ubruhin/hydro-battery-charger/README.md

# Hydro Battery Charger

## Description

This is a [LibrePCB](https://librepcb.org) project for a hydro power battery
charger PCB, controlled by a STM32L0 microcontroller.

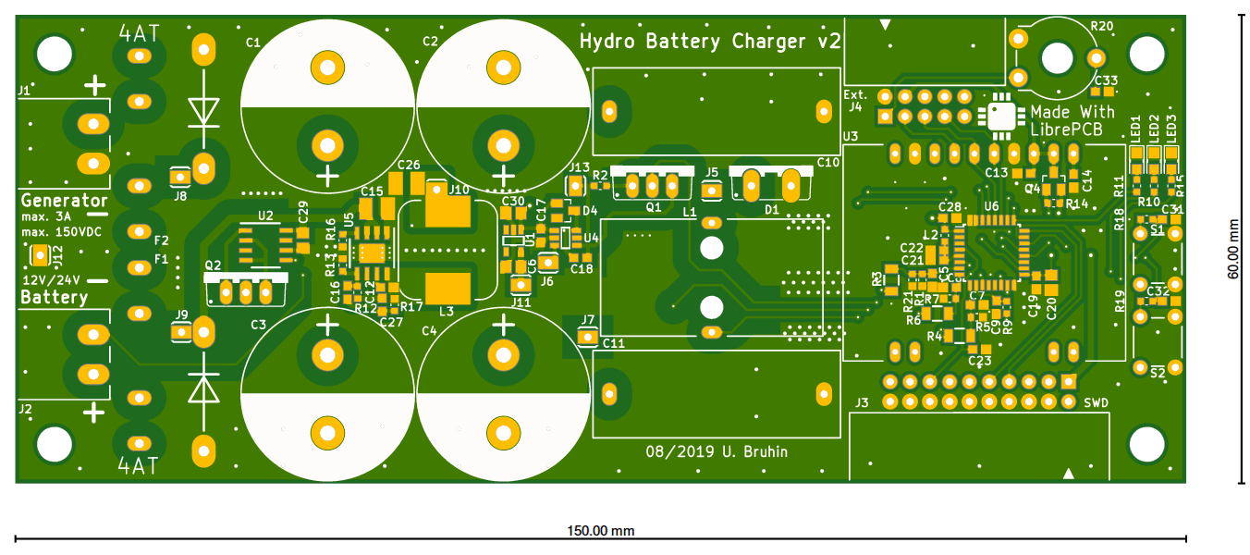
[picture p1: resources/pcb_top.png]
PCB Top


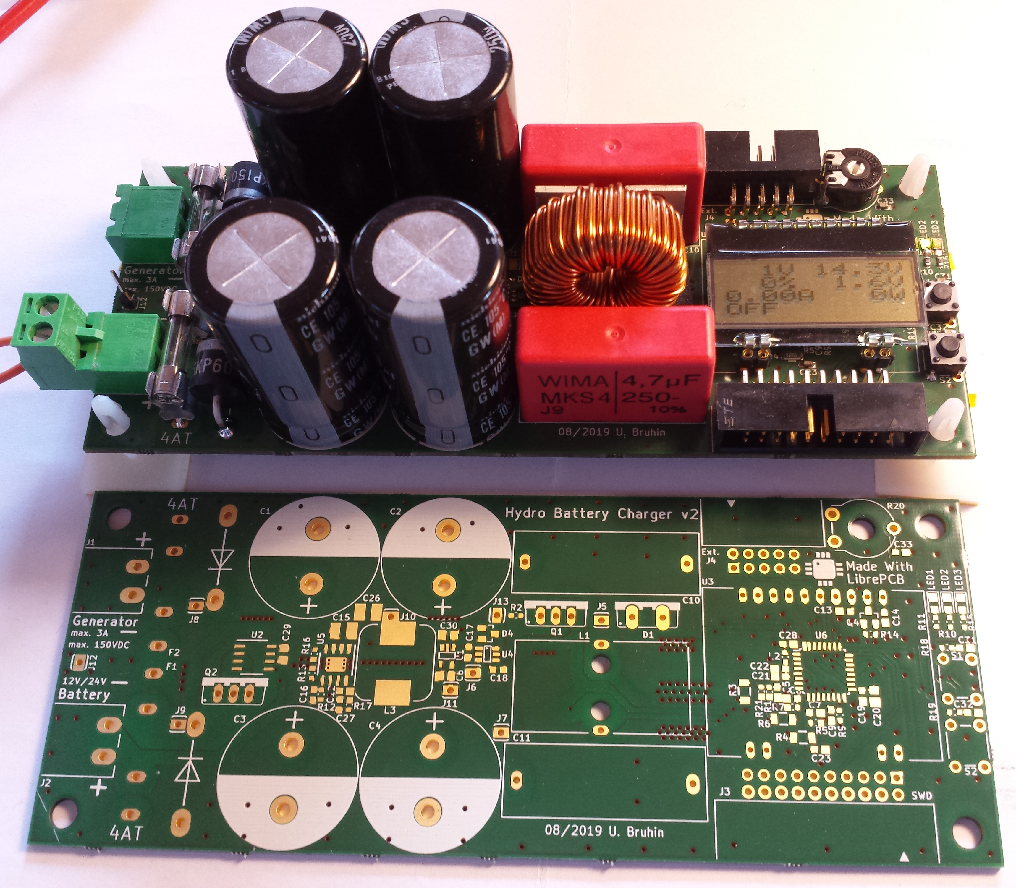
[picture p2: resources/pcb_finished.jpg]
PCB Finished


## License

See [LICENSE.txt](LICENSE.txt).
