ubruhin/hydro-battery-charger/mechanics/button/UM2_button.3mf

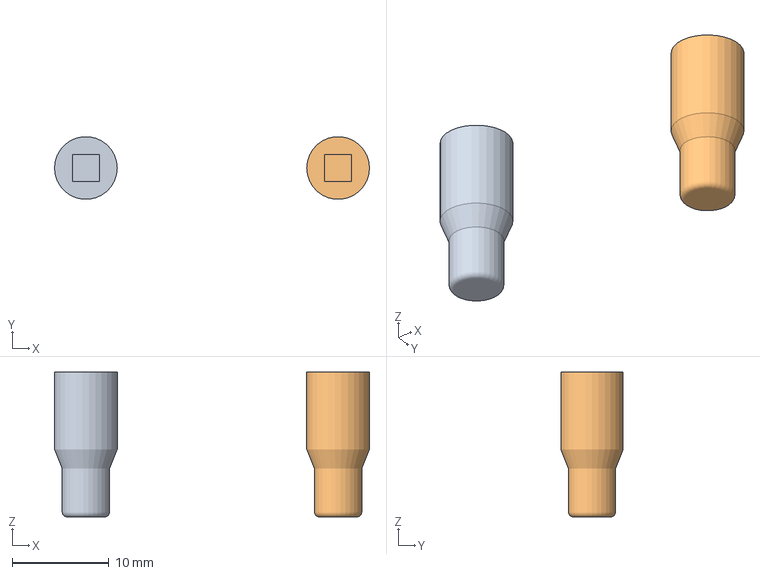
[picture p3: CAD file, 2020-04-19]
mechanics/button/UM2_button.3mf
32.6 x 6.46 x 15.0 mm
