ubruhin/hydro-battery-charger/mechanics/connector_cover/connector_cover.stl

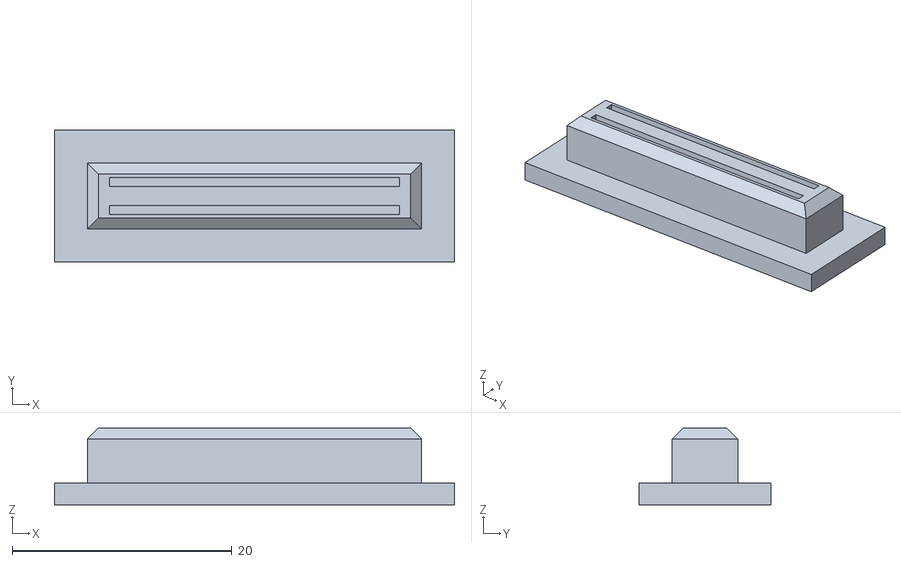
[picture p4: CAD file, 2020-04-19]
mechanics/connector_cover/connector_cover.stl
36.4 x 12.0 x 7.00
