ubruhin/hydro-battery-charger/mechanics/display_holder/display_holder.stl

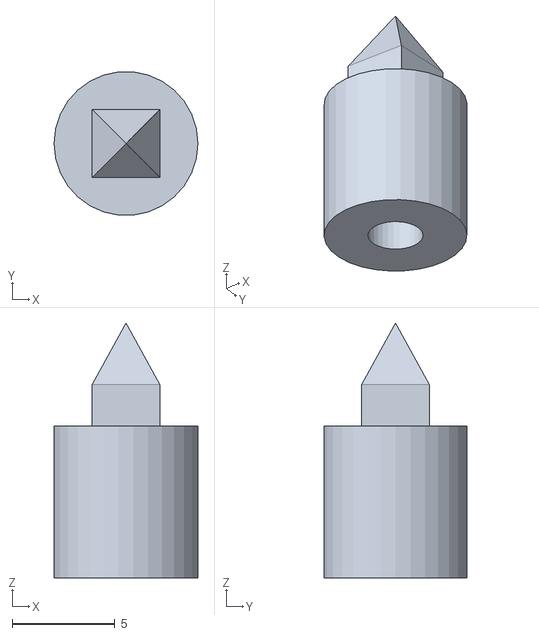
[picture p5: CAD file, 2020-04-19]
mechanics/display_holder/display_holder.stl
7.00 x 6.96 x 12.4
