ubruhin/hydro-battery-charger/mechanics/frontpanel/frontpanel.stl

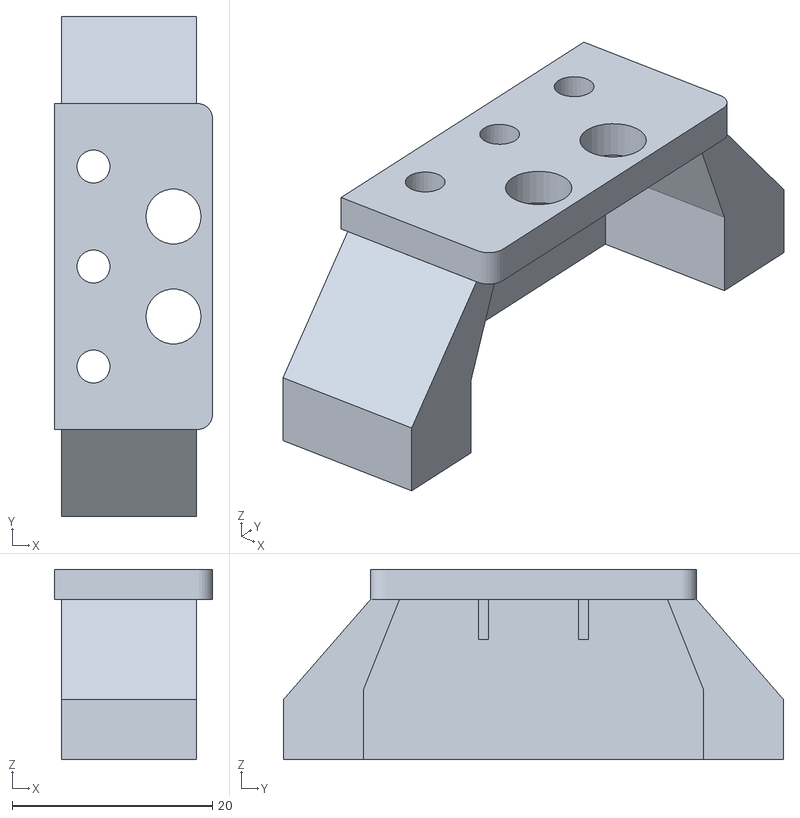
[picture p6: CAD file, 2020-06-29]
mechanics/frontpanel/frontpanel.stl
15.8 x 50.0 x 19.0
