ubruhin/hydro-battery-charger/mechanics/pot_cover/pot_cover.stl

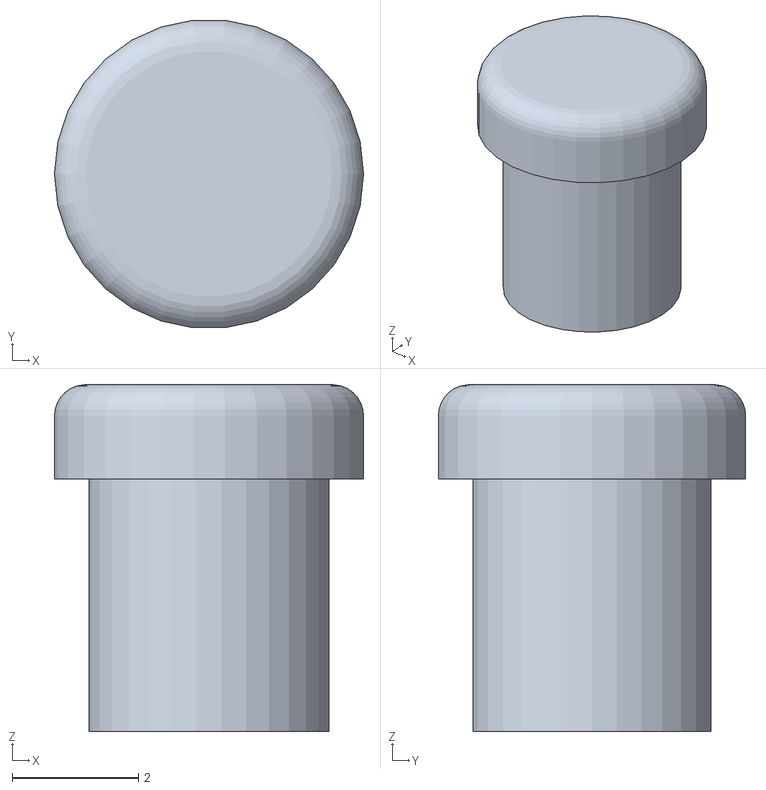
[picture p7: CAD file, 2020-04-19]
mechanics/pot_cover/pot_cover.stl
4.90 x 4.87 x 5.50
