ubruhin/hydro-battery-charger/mechanics/side_cutout/side_cutout_right.dxf

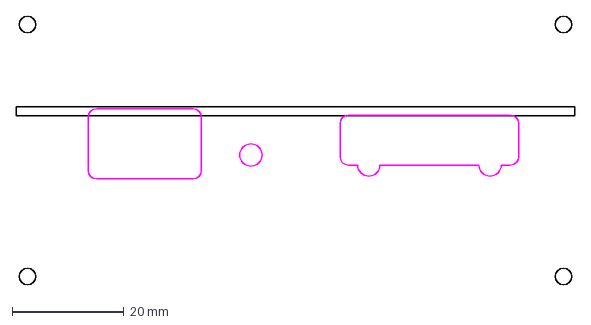
[picture p8: CAD file, 2020-08-07]
mechanics/side_cutout/side_cutout_right.dxf
100.0 x 48.1 mm
