ubruhin/hydro-battery-charger/mechanics/side_label/side_label_right.dxf

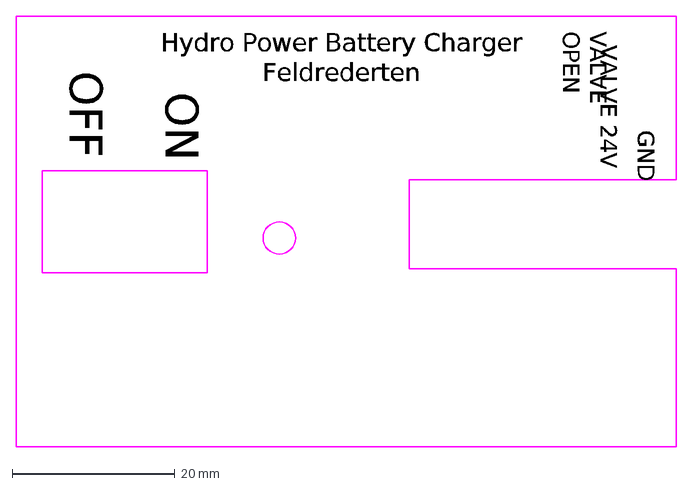
[picture p9: CAD file, 2020-08-07]
mechanics/side_label/side_label_right.dxf
Hydro Power Battery Charger Feldrederten
VALVE 24V
GND
VALVE OPEN
ON
OFF
