ubruhin/hydro-battery-charger/mechanics/button/button.stl

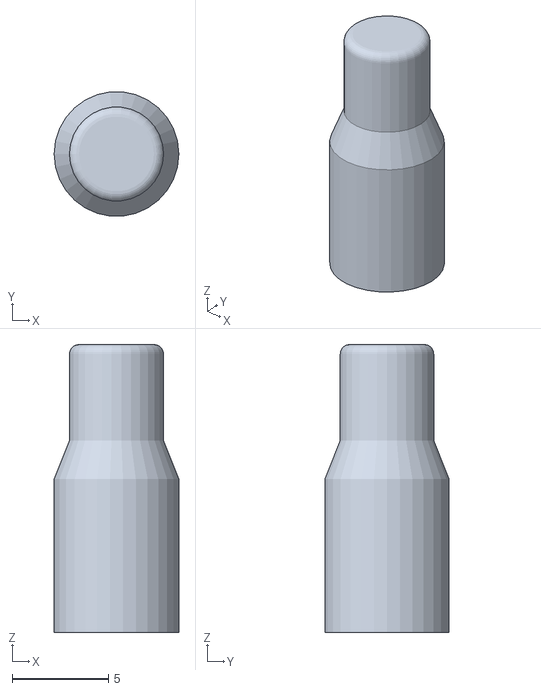
[picture p10: CAD file, 2020-04-19]
mechanics/button/button.stl
6.50 x 6.46 x 15.0
