ubruhin/hydro-battery-charger/mechanics/display_holder/UM2_display_holder.3mf

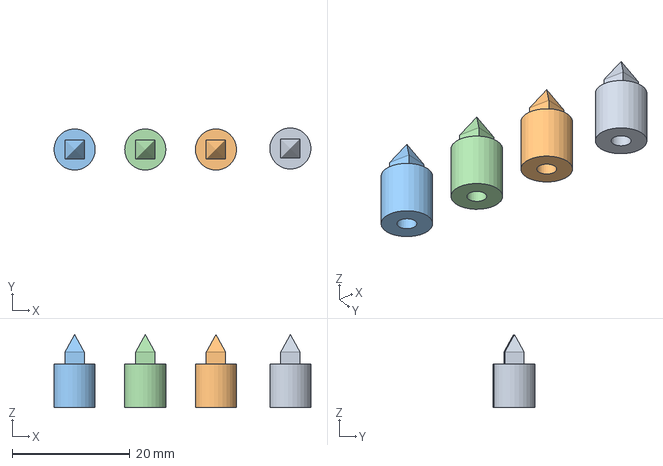
[picture p11: CAD file, 2020-04-19]
mechanics/display_holder/UM2_display_holder.3mf
43.6 x 7.13 x 12.4 mm
