ubruhin/hydro-battery-charger/mechanics/frontpanel/UM2_frontpanel.3mf

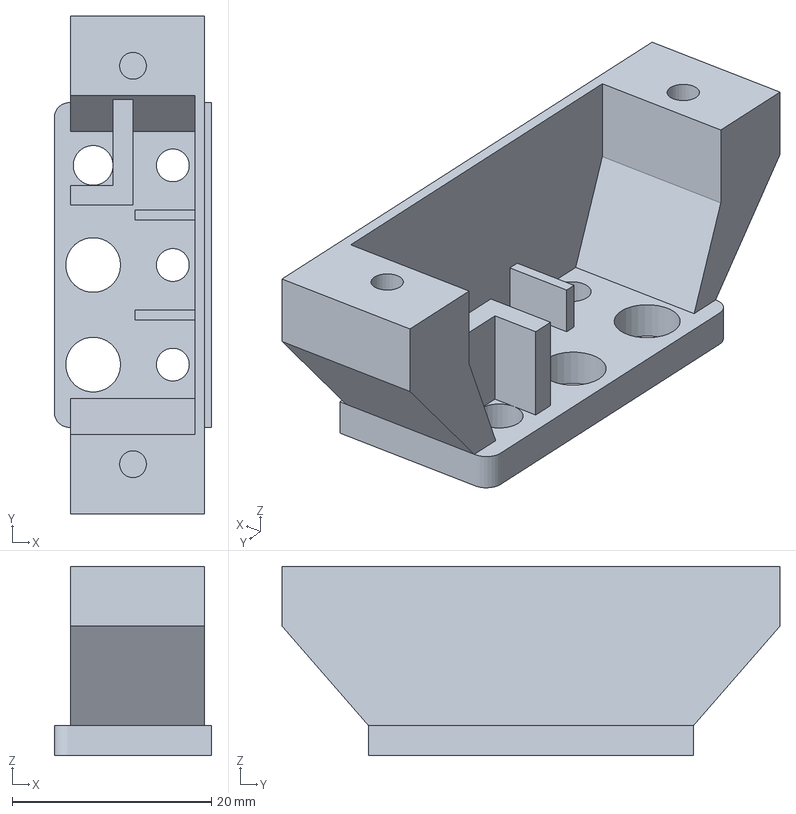
[picture p12: CAD file, 2020-04-19]
mechanics/frontpanel/UM2_frontpanel.3mf
15.8 x 50.0 x 19.0 mm
