ubruhin/hydro-battery-charger/mechanics/side_cutout/side_cutout_left.dxf

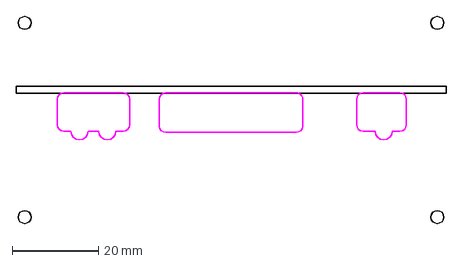
[picture p13: CAD file, 2020-04-19]
mechanics/side_cutout/side_cutout_left.dxf
100.0 x 48.1 mm
