ubruhin/hydro-battery-charger/mechanics/side_label/side_label_left.dxf

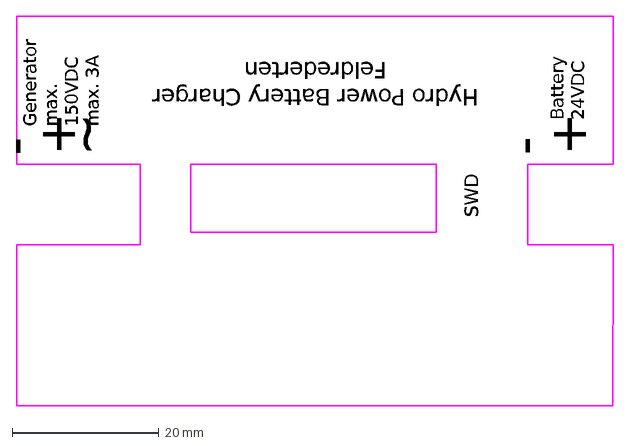
[picture p14: CAD file, 2020-06-07]
mechanics/side_label/side_label_left.dxf
SWD
Hydro Power Battery Charger Feldrederten
+
-
~
Battery 24VDC
Generator max. 150VDC max. 3A
