ubruhin/hydro-battery-charger/(list of files, cad)

Other CAD files:
mechanics/connector_cover/UM2_connector_cover.3mf
mechanics/pot_cover/UM2_pot_cover.3mf
