ubruhin/hydro-battery-charger/pcb/CHANGELOG.md

# Hydro Battery Charger

## Unreleased

- Maybe add motor driver to control a valve?

## v3

- Simplify button circuits to fix WKUP feature
- Replace display by NHD-0420AZ-FSW-GBW-33V3
- Add RPM measure circuit
- Remove ext. connector
- Complete redesign of board to fit in a enclosure

## v2

- Change R3/R4/R6 to 1206 package

## v1

- Initial version
