ubruhin/hydro-battery-charger/pcb/output/v4/Hydro_Battery_Charger_Board_Bottom.pdf

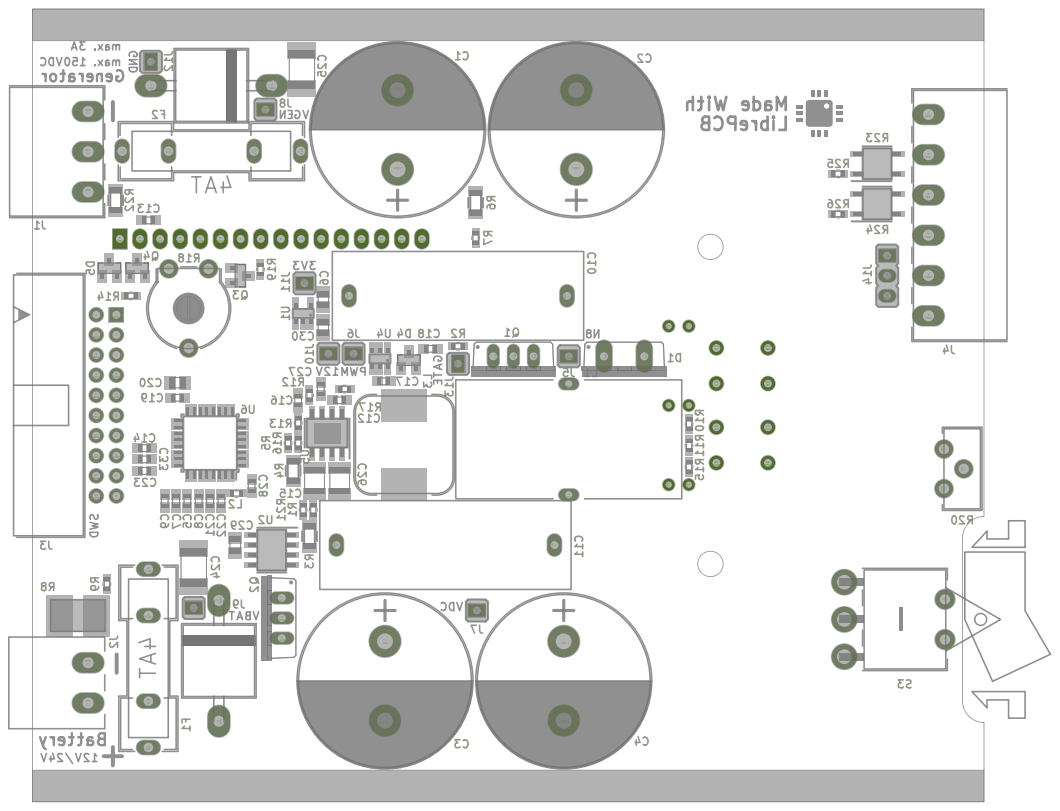
[picture p15: page 1]
S: POT; A: GND; VDC; 2: GND; 1: VGEN; GND C:; 3V3_DISPLAY A:; 1: VDC; C: GND; 2A: BUTTON2; 2B: BUTTON2; 5: GND; 11: DISPLAY_DB4; 14: DISPLAY_DB7; 15: N13 8 4: DISPLAY_RS; 6: DISPLAY_E; 2: 3V3_DISPLAY; 12: DISPLAY_DB5; 16: GND; 13: DISPLAY_DB6; 1: GND
