ubruhin/hydro-battery-charger/mechanics/side_label/side_label_right.pdf

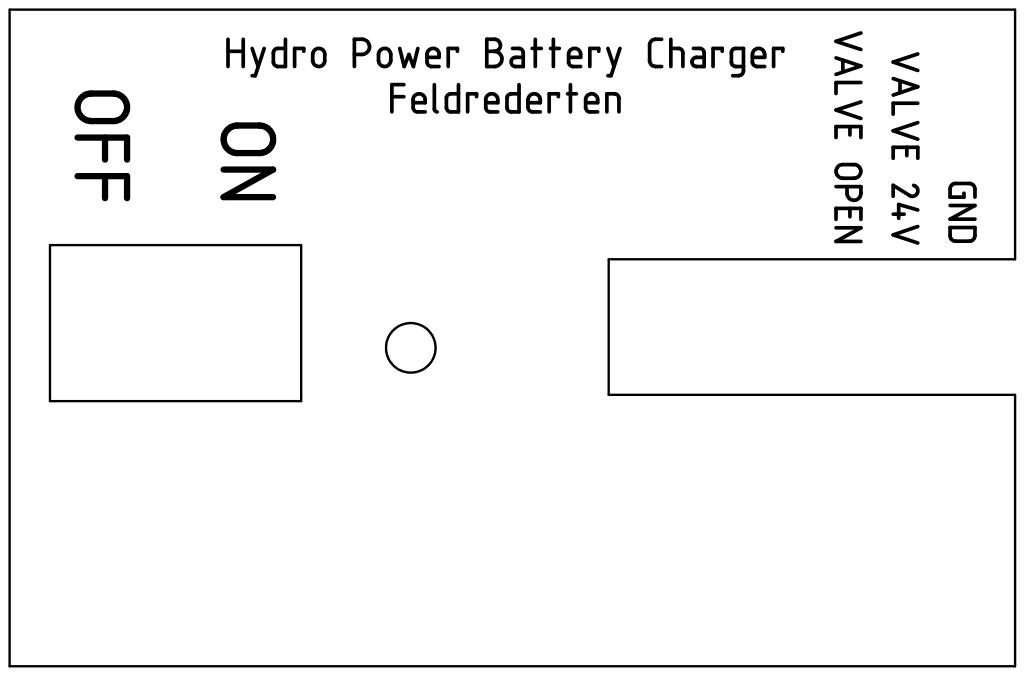
[picture p16: page 1]
