ubruhin/hydro-battery-charger/mechanics/side_label/side_label_left.pdf

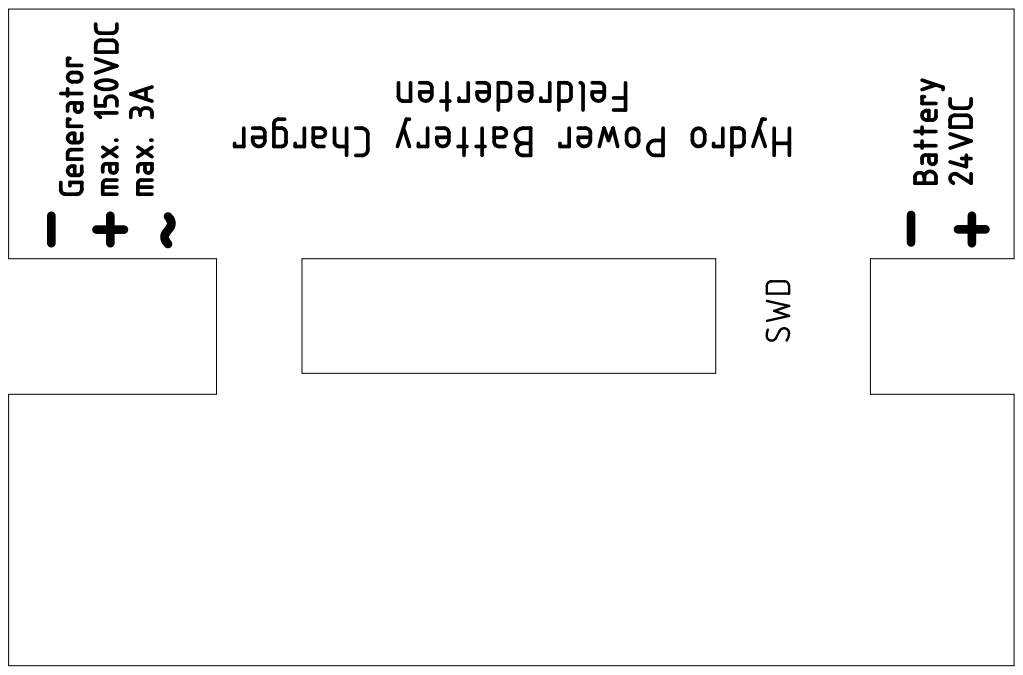
[picture p17: page 1]
