ubruhin/hydro-battery-charger/pcb/output/v4/Hydro_Battery_Charger_Schematics.pdf

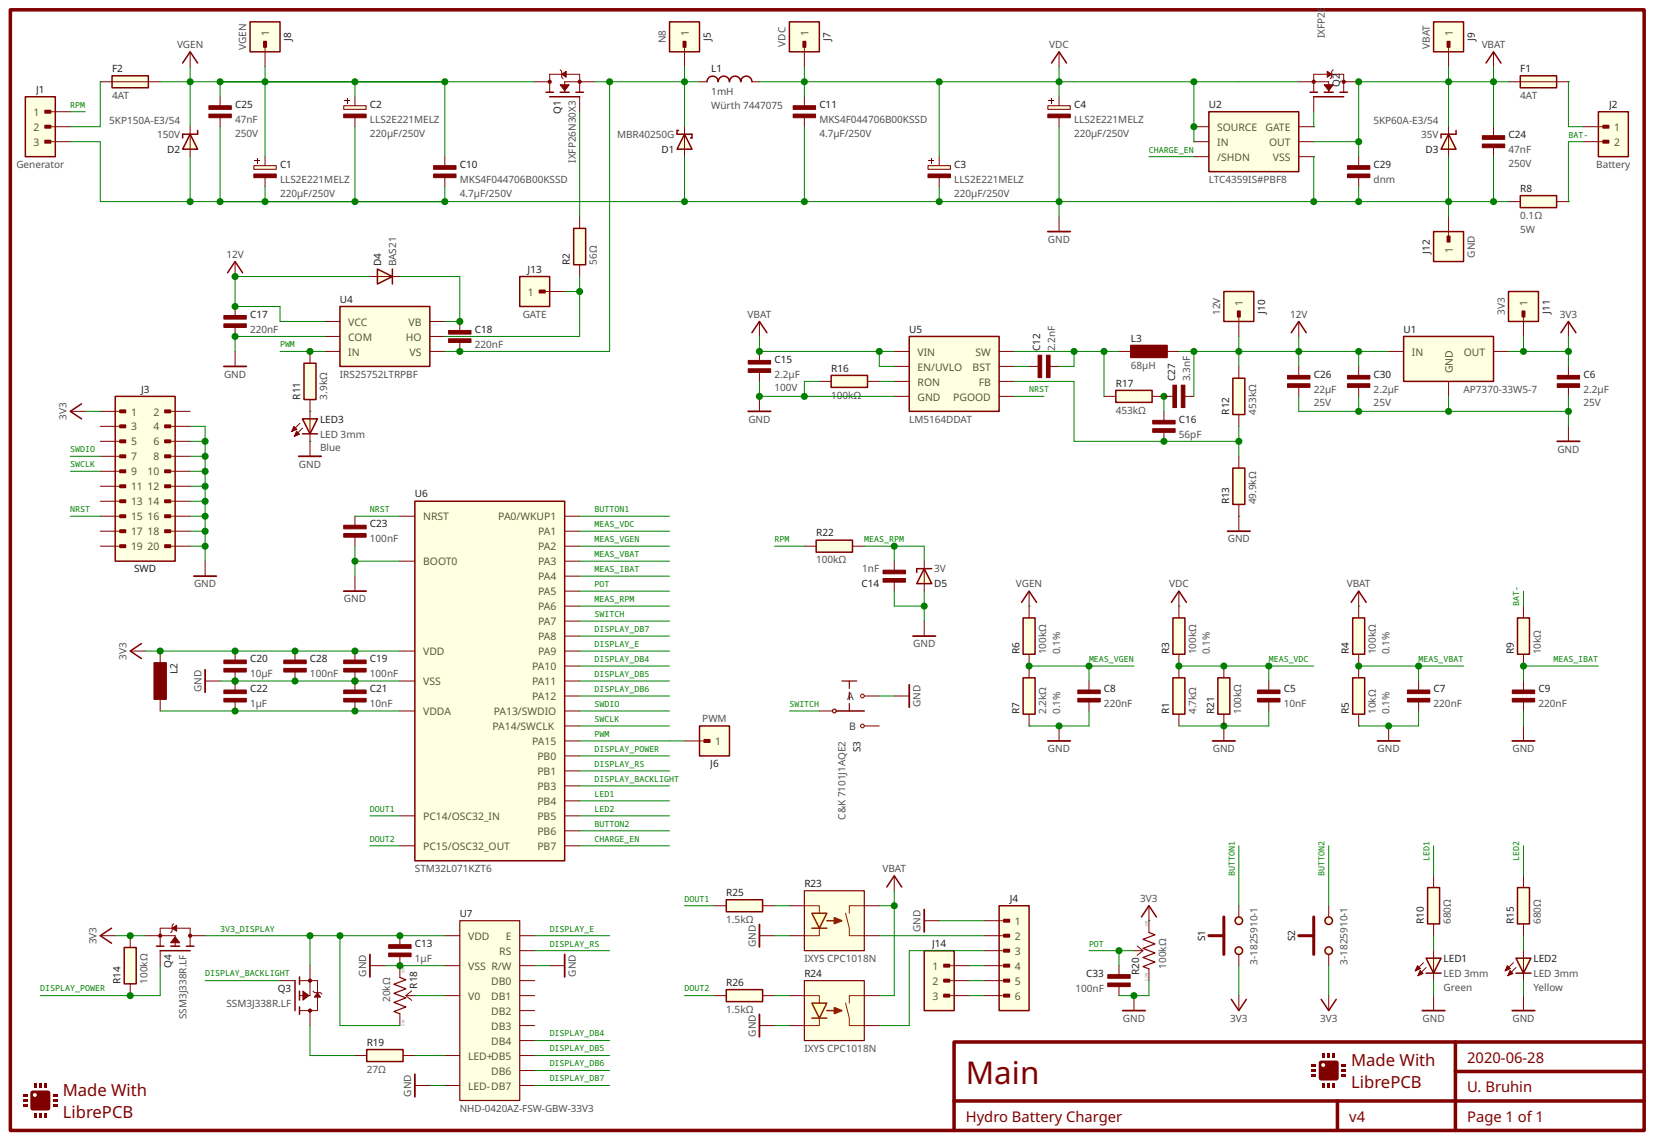
[picture p18: page 1]
