ubruhin/hydro-battery-charger/pcb/output/v3/Hydro_Battery_Charger_Schematics.pdf

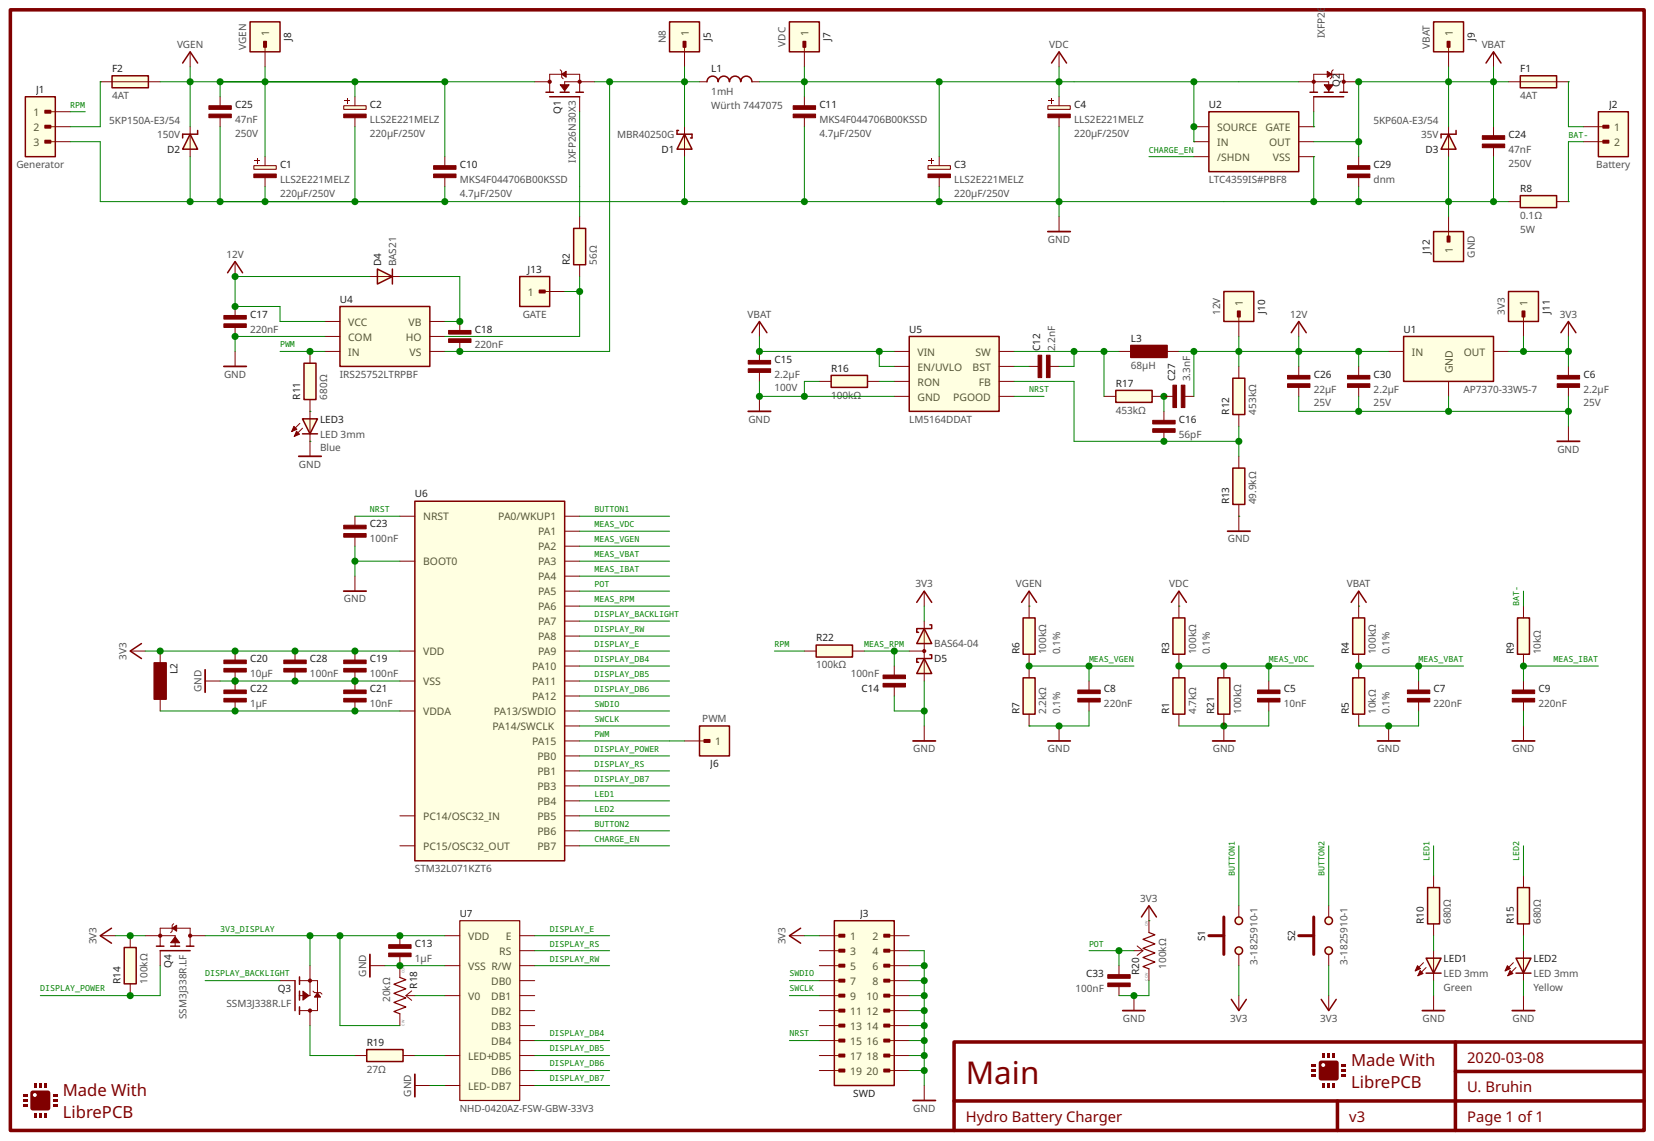
[picture p19: page 1]
