ubruhin/hydro-battery-charger/pcb/output/v2/Hydro_Battery_Charger_Schematics.pdf

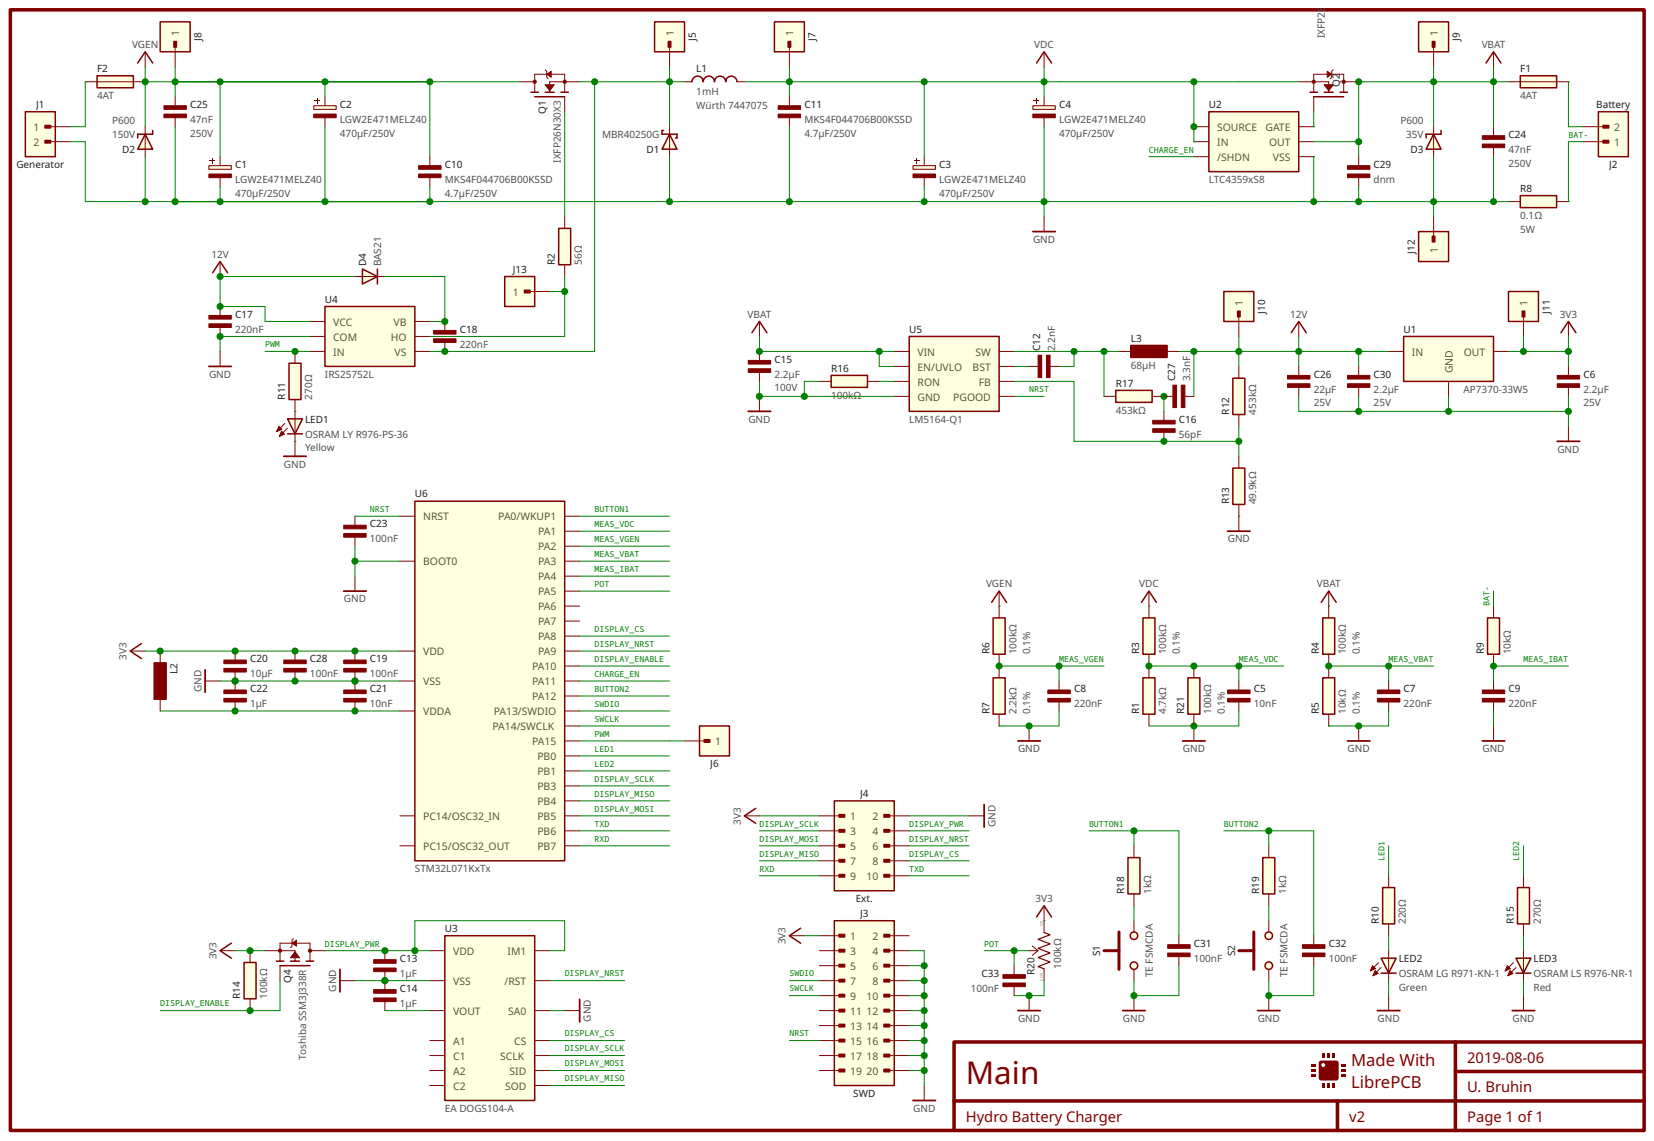
[picture p20: page 1]
