ubruhin/hydro-battery-charger/pcb/output/v1/Hydro_Battery_Charger_Schematics.pdf

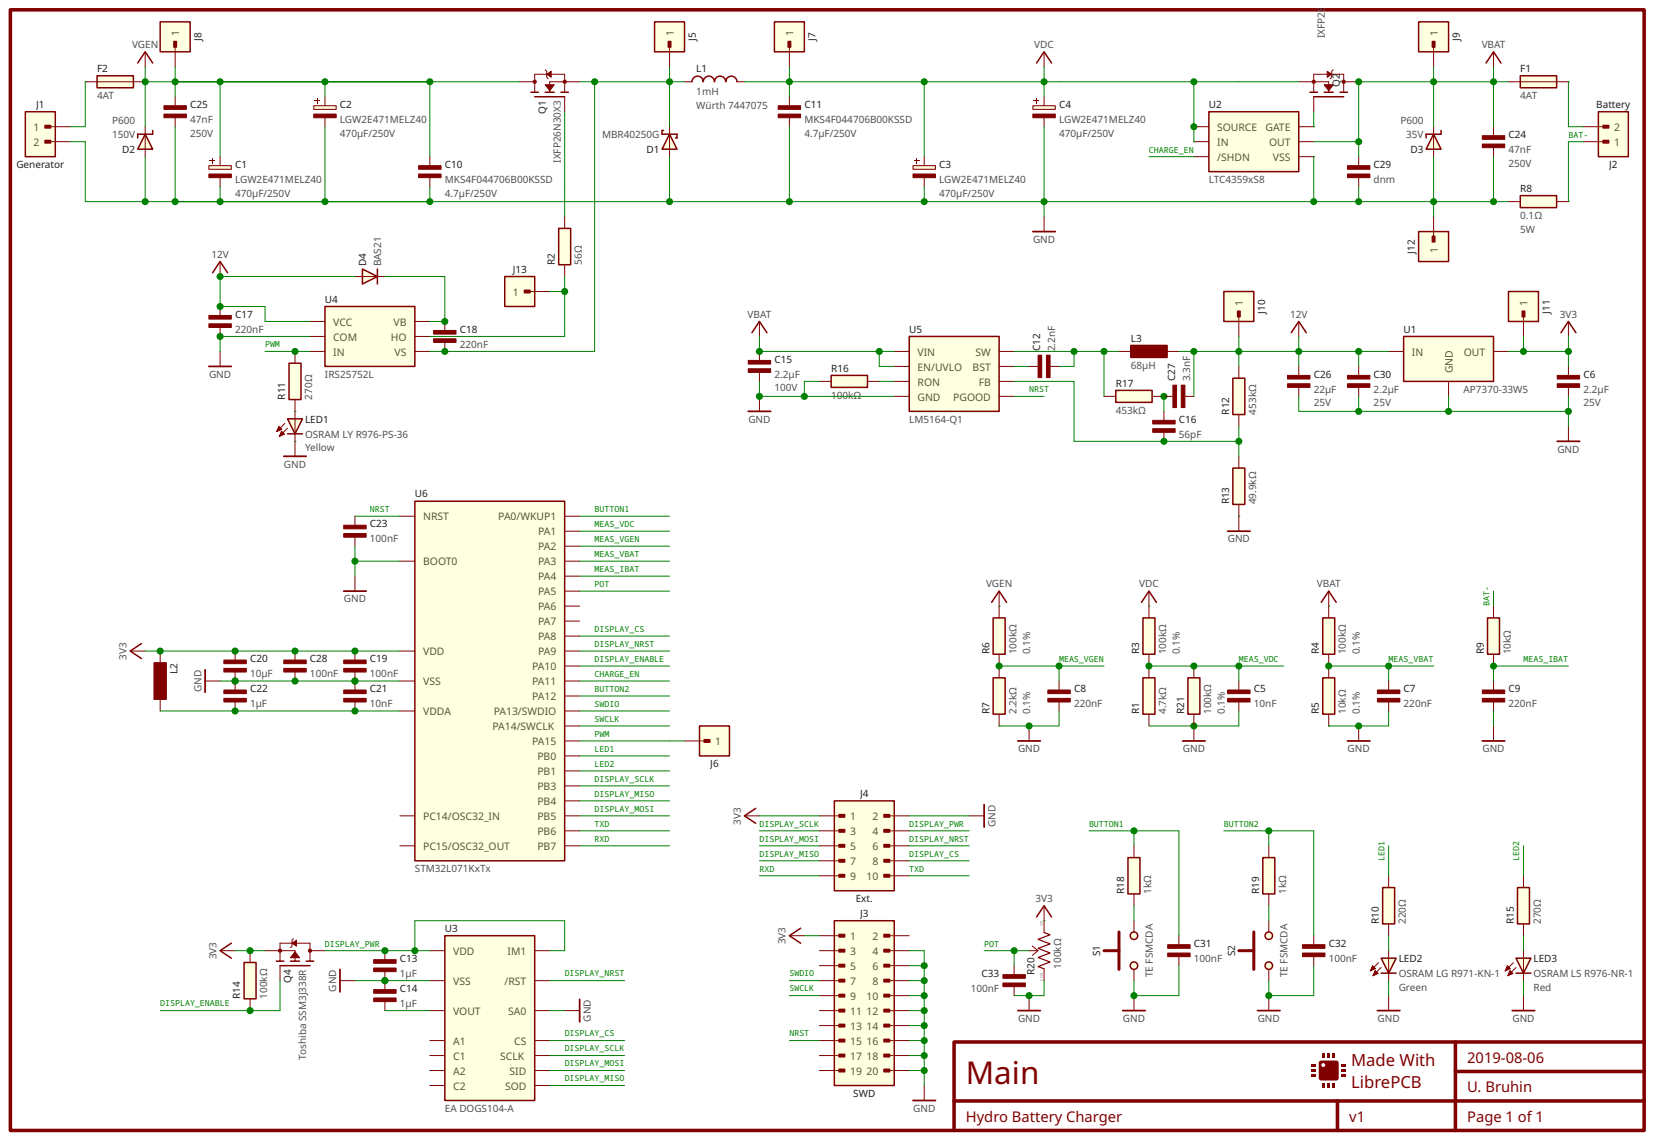
[picture p21: page 1]
