ubruhin/hydro-battery-charger/simulation/hydro-battery-charger.asc

C2: cap; 10n
C3: cap; 220n
C4: cap; 220n
C5: cap; 470µ
C6: cap; 470µ
C7: cap; 4.7µ
C8: cap; 470µ
C9: cap; 470µ
C10: cap; 4.7µ
C11: cap; 10n
D1: schottky; MBR40250
D2: diode
D3: diode
D4: diode
D5: diode
D6: diode; BAS21HM
D7: diode
D8: diode
L1: ind; 860µ
M1: nmos; IRFR2307Z
M2: nmos; IRFR2307Z
R1: res; 0.1
R2: res; 10
U1: IRS25752L
U2: LTC4359
V1: battery; 24; Rser=1
V2: voltage; SINE(0 50 500 0 0 -120); Rser=1
V3: voltage; PULSE(0 3.3 0 0 0 5u 10u)
V4: voltage; PULSE(0 12 0 0 0 100m); Rser=10
V5: voltage; SINE(0 50 500); Rser=1
V6: voltage; SINE(0 50 500 0 0 120); Rser=1
Named nets: 0
.tran 0 100m 0 startup
