ubruhin/hydro-battery-charger/(commit log)

2019-08-04 Add second push button and debounce circuit
2019-08-04 Improve silkscreen
2019-08-04 Fix missing connection in PCB
2019-08-05 Minor adjustments in footprints and board
2019-08-06 Add parallel resistor to VDC measurement circuit
2019-08-06 Replace copper polygon by vias and traces
2019-08-06 Release v1
    [BOM.csv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]
2019-08-06 Release v2
    [BOM.csv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]
2019-10-29 Add photo of finished board
2020-02-26 Simplify button circuits to fix WKUP feature
2020-03-06 Change board size to 120x100mm
2020-03-06 Remove Ext. connector
2020-03-08 Complete redesign of board
2020-03-08 Release v3
    [Hydro_Battery_Charger.gbl, Hydro_Battery_Charger.gbo, Hydro_Battery_Charger.gbp, Hydro_Battery_Charger.gbs, Hydro_Battery_Charger.gm1, Hydro_Battery_Charger.gtl, Hydro_Battery_Charger.gto, Hydro_Battery_Charger.gtp]
2020-03-08 Fix typo in MPN
    [Hydro_Battery_Charger_BOM.csv]
2020-03-19 Add more output files for v3
    [Hydro_Battery_Charger_BOM.ods]
2020-03-19 Move LibrePCB project into subdirectory "pcb"
    [BOM.csv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]
2020-03-29 Update BOM
    [Hydro_Battery_Charger_BOM.csv]
2020-03-29 Add datasheet of enclosure
2020-04-19 Add OpenSCAD models for mechanics
    [UM2_button.3mf, UM2_connector_cover.3mf, UM2_display_holder.3mf, UM2_frontpanel.3mf, UM2_pot_cover.3mf, button.scad, button.stl, connector_cover.scad]
2020-04-19 Add 2D drawings and G-Code for enclosure cutouts
    [side_cutout.dxf]
2020-06-07 Add side label drawing
    [side_label.dxf]
2020-06-07 Change D5 to a Zener diode
2020-06-20 Hardwire DISPLAY_RW to GND
2020-06-26 Add rocker switch
2020-06-26 Move potentiometer to board edge
2020-06-28 Fix wrong board side of some parts
2020-06-28 Release v4
    [Hydro_Battery_Charger.gbl, Hydro_Battery_Charger.gbo, Hydro_Battery_Charger.gbp, Hydro_Battery_Charger.gbs, Hydro_Battery_Charger.gm1, Hydro_Battery_Charger.gtl, Hydro_Battery_Charger.gto, Hydro_Battery_Charger.gtp]
2020-06-29 Remove potentiometer from frontpanel 3D model
    [frontpanel.scad, frontpanel.stl]
2020-08-07 Add drawings for right side cutout & label
    [side_cutout_left.dxf, side_cutout_right.dxf, side_label_left.dxf, side_label_right.dxf]
